roscopeco/atfprog-hardware/README.md

## ATF150x programmer (commercial)

Made non-proprietary and released to open-source with the
licenses outlined in LICENSE.md and LICENSE.hardware, 
under my authority on April 23rd 2025.

_Ross Bamford_

_Managing Director_

_The Really Old-School Company Limited_
