roscopeco/atfprog-hardware/ATF15xxProgBoard/ATF15xxProgBoard.pdf

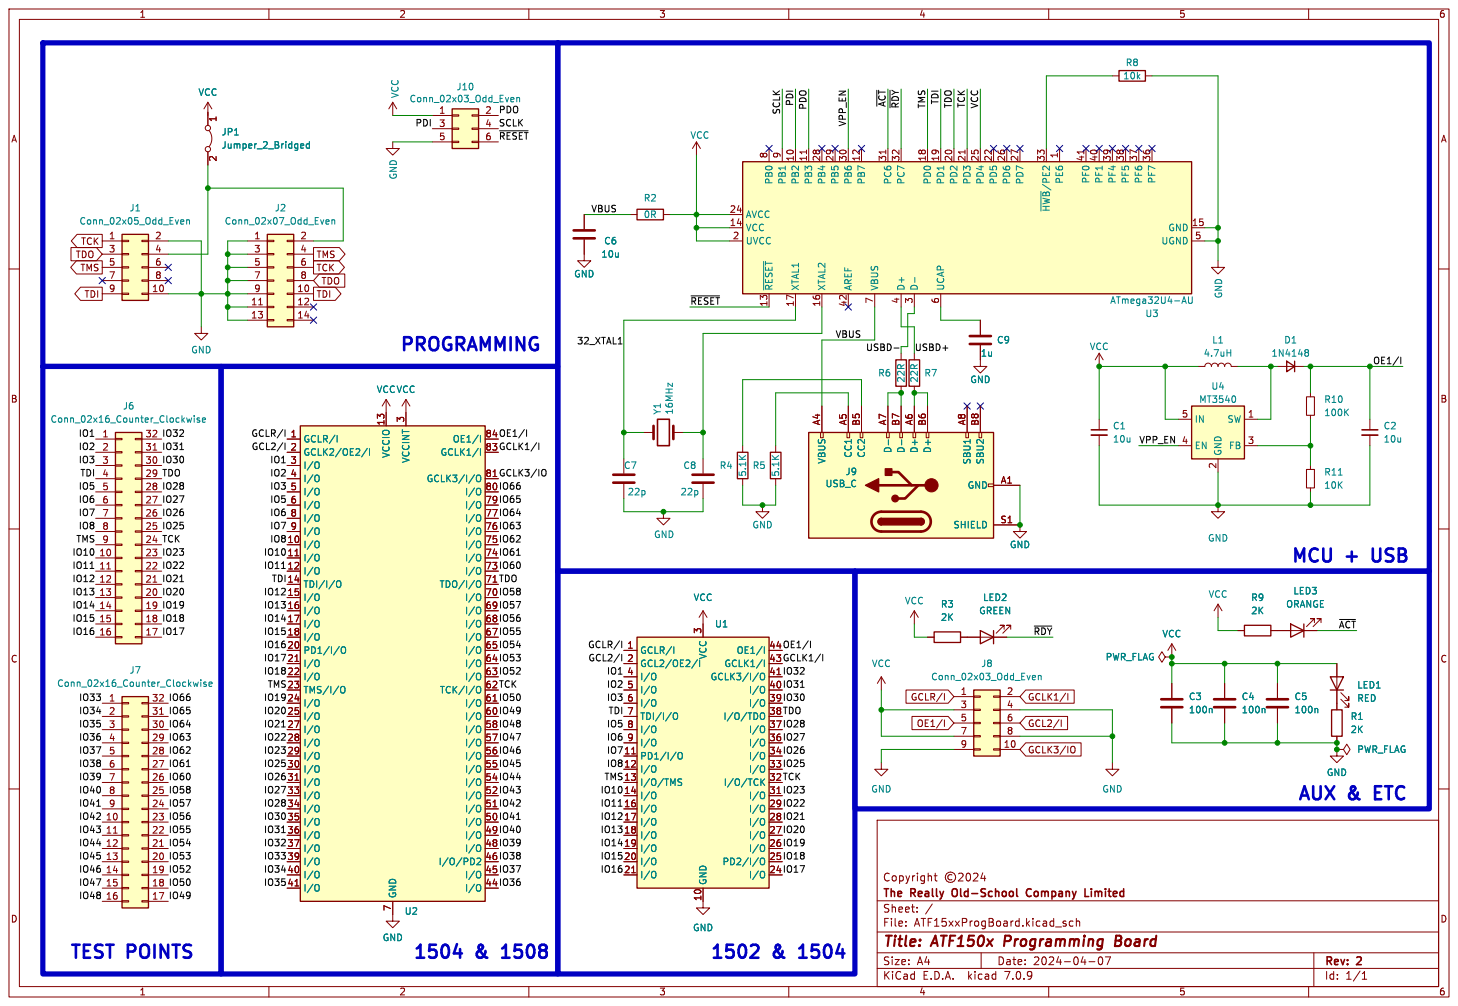
[picture p2: page 1]

1 PB2 10 PB3 11 PB7 12 ~{RESET} 13 VCC 14 GND 15 XTAL2 16 XTAL1 17 PD0 18 PD1 19 UVCC 2 PD2 20 PD3 21 PD5 22 AVCC 24 PD4 25 PD6 26 PD7 27 PB4 28 PB5 29 D- 3 PB6 30 PC6 31 PC7 32 ~{HWB}/PE233 PF7 36 PF6 37 PF5 38 PF4 39 D+

9 U3 ATmega32U4-AU GND A1 VBUS A4 CC1 A5 D+ A6 D- A7 SBU1 A8 CC2 B5 D+ B6 D- B7 SBU2 B8 SHIELD S1

Id: 1/1 Title: ATF150x Programming Board
