roscopeco/atfprog-hardware/ATF15xxProgBoard/ATF15xxProgBoard.kicad_pcb

## KiCad design ATF15xxProgBoard/ATF15xxProgBoard.kicad_pcb (2025-07-12)

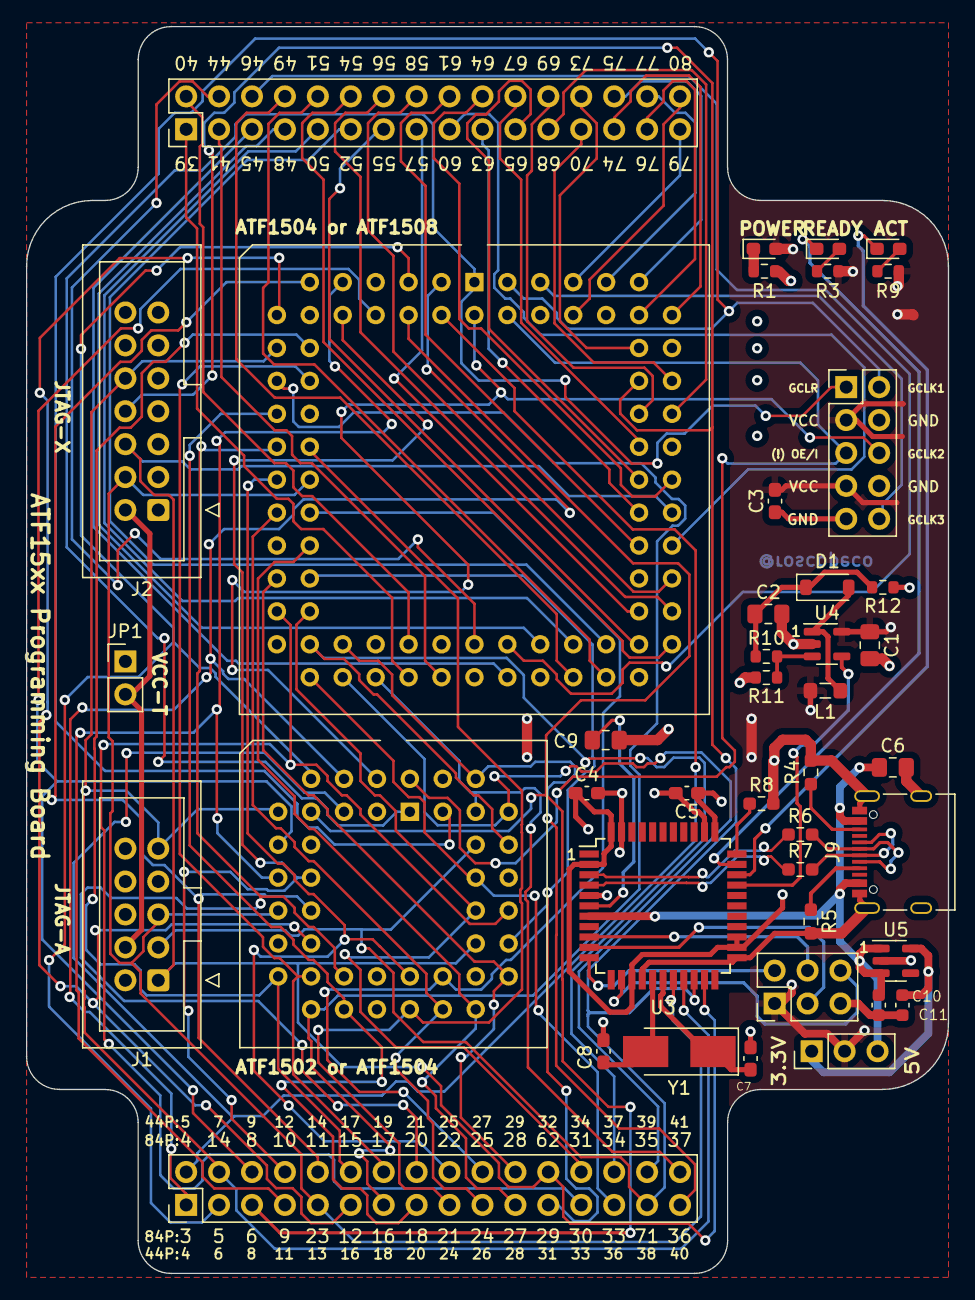
[picture p3: board ATF15xxProgBoard.kicad_pcb from above]

Board: 4 copper layers, 71.1 x 96.2 mm, 42 parts (0 on the bottom side), 97 nets.

Parts:
C1, C2, C6: 10u; C_0805_2012Metric_Pad1.18x1.45mm_HandSolder
C3, C4, C5: 100n; C_0603_1608Metric_Pad1.08x0.95mm_HandSolder
C7, C8: 22p; C_0603_1608Metric_Pad1.08x0.95mm_HandSolder
C9: 1u; C_0805_2012Metric_Pad1.18x1.45mm_HandSolder
C10, C11: 4.7u; C_0603_1608Metric
D1: 1N4148; D_SOD-123
J1: Conn_02x05_Odd_Even; IDC-Header_2x05_P2.54mm_Vertical
J2: Conn_02x07_Odd_Even; IDC-Header_2x07_P2.54mm_Vertical
J6, J7: Conn_02x16_Counter_Clockwise; PinHeader_2x16_P2.54mm_Vertical
J8: Conn_02x03_Odd_Even; PinHeader_2x05_P2.54mm_Vertical
J9: USB_C; USB_C_Receptacle_Palconn_UTC16-G
J10: Conn_02x03_Odd_Even; PinHeader_2x03_P2.54mm_Vertical
JP1: Jumper_2_Bridged; PinHeader_1x02_P2.54mm_Vertical
JP2: Voltage; PinHeader_1x03_P2.54mm_Vertical
L1: 4.7uH; L_0805_2012Metric_Pad1.05x1.20mm_HandSolder
LED1: RED; LED_0603_1608Metric_Pad1.05x0.95mm_HandSolder
LED2: GREEN; LED_0603_1608Metric_Pad1.05x0.95mm_HandSolder
LED3: ORANGE; LED_0603_1608Metric_Pad1.05x0.95mm_HandSolder
R1, R3, R9: 2K; R_0603_1608Metric
R4, R5: 5.1K; R_0603_1608Metric_Pad0.98x0.95mm_HandSolder
R6, R7: 22R; R_0603_1608Metric_Pad0.98x0.95mm_HandSolder
R8: 10k; R_0603_1608Metric_Pad0.98x0.95mm_HandSolder
R10: 100K; R_0603_1608Metric
R11: 10K; R_0603_1608Metric
R12: 2.2K; R_0603_1608Metric
U1: PLCC-44_THT-Socket
U2: PLCC-84_THT-Socket
U3: ATmega32U4-AU; TQFP-44_10x10mm_P0.8mm
U4: MT3540; SOT-23-5
U5: AP2127K-3.3; SOT-23-5
Y1: 8MHz; Crystal_SMD_5032-2Pin_5.0x3.2mm_HandSoldering

Connections:
+3V3: C11.1, JP2.1 (A), U5.5 (VOUT)
/32_XTAL1: C7.1, U3.17 (XTAL1), Y1.1
/IO1: J6.1, U1.4 (I/O), U2.3 (I/O)
/IO2: J6.2, U1.5 (I/O), U2.4 (I/O)
/IO3: J6.3, U1.6 (I/O), U2.5 (I/O)
/IO5: J6.5, U1.8 (I/O), U2.6 (I/O)
/IO6: J6.6, U1.9 (I/O), U2.8 (I/O)
/IO7: J6.7, U1.11 (PD1/I/O), U2.9 (I/O)
/IO8: J6.8, U1.12 (I/O), U2.10 (I/O)
/IO10: J6.10, U1.14 (I/O), U2.11 (I/O)
/IO11: J6.11, U1.16 (I/O), U2.12 (I/O)
/IO12: J6.12, U1.17 (I/O), U2.15 (I/O)
/IO13: J6.13, U1.18 (I/O), U2.16 (I/O)
/IO14: J6.14, U1.19 (I/O), U2.17 (I/O)
/IO15: J6.15, U1.20 (I/O), U2.18 (I/O)
/IO16: J6.16, U1.21 (I/O), U2.20 (PD1/I/O)
/IO17: J6.17, U1.24 (I/O), U2.21 (I/O)
/IO18: J6.18, U1.25 (PD2/I/O), U2.22 (I/O)
/IO19: J6.19, U1.26 (I/O), U2.24 (I/O)
/IO20: J6.20, U1.27 (I/O), U2.25 (I/O)
/IO21: J6.21, U1.28 (I/O), U2.27 (I/O)
/IO22: J6.22, U1.29 (I/O), U2.28 (I/O)
/IO23: J6.23, U1.31 (I/O), U2.29 (I/O)
/IO25: J6.25, U1.33 (I/O), U2.30 (I/O)
/IO26: J6.26, U1.34 (I/O), U2.31 (I/O)
/IO27: J6.27, U1.36 (I/O), U2.33 (I/O)
/IO28: J6.28, U1.37 (I/O), U2.34 (I/O)
/IO30: J6.30, U1.39 (I/O), U2.35 (I/O)
/IO31: J6.31, U1.40 (I/O), U2.36 (I/O)
/IO32: J6.32, U1.41 (GCLK3/I/O), U2.37 (I/O)
/IO33: J7.1, U2.39 (I/O)
/IO34: J7.2, U2.40 (I/O)
/IO35: J7.3, U2.41 (I/O)
/IO36: J7.4, U2.44 (I/O)
/IO37: J7.5, U2.45 (I/O)
/IO38: J7.6, U2.46 (I/O/PD2)
/IO39: J7.7, U2.48 (I/O)
/IO40: J7.8, U2.49 (I/O)
/IO41: J7.9, U2.50 (I/O)
/IO42: J7.10, U2.51 (I/O)
/IO43: J7.11, U2.52 (I/O)
/IO44: J7.12, U2.54 (I/O)
/IO45: J7.13, U2.55 (I/O)
/IO46: J7.14, U2.56 (I/O)
/IO47: J7.15, U2.57 (I/O)
/IO48: J7.16, U2.58 (I/O)
/IO49: J7.17, U2.60 (I/O)
/IO50: J7.18, U2.61 (I/O)
/IO52: J7.19, U2.63 (I/O)
/IO53: J7.20, U2.64 (I/O)
/IO54: J7.21, U2.65 (I/O)
/IO55: J7.22, U2.67 (I/O)
/IO56: J7.23, U2.68 (I/O)
/IO57: J7.24, U2.69 (I/O)
/IO58: J7.25, U2.70 (I/O)
/IO60: J7.26, U2.73 (I/O)
/IO61: J7.27, U2.74 (I/O)
/IO62: J7.28, U2.75 (I/O)
/IO63: J7.29, U2.76 (I/O)
/IO64: J7.30, U2.77 (I/O)
/IO65: J7.31, U2.79 (I/O)
/IO66: J7.32, U2.80 (I/O)
/PDI: J10.3, U3.10 (PB2)
/PDO: J10.2, U3.11 (PB3)
/SCLK: J10.4, U3.9 (PB1)
/USBD+: R7.1, U3.4 (D+)
/USBD-: R6.1, U3.3 (D-)
/VPP_EN: U3.30 (PB6), U4.4 (EN)
/~ACT: LED3.1 (K), U3.31 (PC6)
/~RDY: LED2.1 (K), U3.32 (PC7)
/~RESET: J10.6, U3.13 (~RESET)
GCL2/I: J8.6, U1.2 (GCL2/OE2/I), U2.2 (GCLK2/OE2/I)
GCLK1/I: J8.2, U1.43 (GCLK1/I), U2.83 (GCLK1/I)
GCLK3/IO: J8.10, U2.81 (GCLK3/I/O)
GCLR/I: J8.1, U1.1 (GCLR/I), U2.1 (GCLR/I)
GND: C1.2, C2.2, C3.1, C4.2, C5.2, C6.2, C7.2, C8.2, C9.2, C10.2, C11.2, J1.2, J1.10, J2.1, J2.3, J2.5, J2.7, J2.9, J2.11, J2.13, J8.4, J8.8, J8.9, J9.A1 (GND), J9.A12 (GND), J9.B1 (GND), J9.B12 (GND), J9.S1 (SHIELD), J10.5, R1.2, R4.2, R5.2, R8.1, R11.2, U1.10 (GND), U1.22 (GND), U1.30 (GND), U1.42 (GND), U2.7 (GND), U2.19 (GND), U2.32 (GND), U2.42 (GND), U2.47 (GND), U2.59 (GND), U2.72 (GND), U2.82 (GND), U3.5 (UGND), U3.15 (GND), U3.23 (GND), U3.35 (GND), U3.43 (GND), U4.2 (GND), U5.2 (GND)
unnamed: D1.2 (A), L1.2, U4.1 (SW)
unnamed: C2.1, D1.1 (K), R10.1, R12.2
unnamed: J1.4, J2.2, JP1.2 (B)
unnamed: J9.A5 (CC1), R5.1
unnamed: J9.B5 (CC2), R4.1
unnamed: J9.A6 (D+), J9.B6 (D+), R7.2
unnamed: J9.A7 (D-), J9.B7 (D-), R6.2
unnamed: LED1.1 (K), R1.1
unnamed: LED2.2 (A), R3.2
unnamed: LED3.2 (A), R9.2
unnamed: C9.1, U3.6 (UCAP)
unnamed: C8.1, U3.16 (XTAL2), Y1.2
unnamed: R8.2, U3.33 (~HWB/PE2)
unnamed: R10.2, R11.1, U4.3 (FB)
OE1/I: J8.5, R12.1, U1.44 (OE1/I), U2.84 (OE1/I)
TCK: J1.1, J2.6, J6.24, U1.32 (I/O/TCK), U2.62 (TCK/I/O), U3.21 (PD3)
TDI: J1.9, J2.10, J6.4, U1.7 (TDI/I/O), U2.14 (TDI/I/O), U3.19 (PD1)
TDO: J1.3, J2.8, J6.29, U1.38 (I/O/TDO), U2.71 (TDO/I/O), U3.20 (PD2)
TMS: J1.5, J2.4, J6.9, U1.13 (I/O/TMS), U2.23 (TMS/I/O), U3.18 (PD0)
VBUS: C6.1, C10.1, J9.A4 (VBUS), J9.A9 (VBUS), J9.B4 (VBUS), J9.B9 (VBUS), JP2.3 (B), U3.7 (VBUS), U5.1 (VIN), U5.3 (EN)
VCC: C1.1, C3.2, C4.1, C5.1, J8.3, J8.7, J10.1, JP1.1 (A), JP2.2 (C), L1.1, LED1.2 (A), R3.1, R9.1, U1.3 (VCC), U1.15 (VCC), U1.23 (VCC), U1.35 (VCC), U2.13 (VCCIO), U2.26 (VCCIO), U2.38 (VCCIO), U2.43 (VCCINT), U2.53 (VCCIO), U2.66 (VCCIO), U2.78 (VCCIO), U3.2 (UVCC), U3.14 (VCC), U3.24 (AVCC), U3.25 (PD4), U3.34 (VCC), U3.44 (AVCC), U4.5 (IN)
