roscopeco/atfprog-hardware/(commit log)

2024-04-12 COMMERCIAL: Full redesign as programmer
    [ATF15xxProgBoard-B_Cu.gbr, ATF15xxProgBoard-B_Mask.gbr, ATF15xxProgBoard-B_Paste.gbr, ATF15xxProgBoard-B_Silkscreen.gbr, ATF15xxProgBoard-CuBottom.gbr, ATF15xxProgBoard-CuIn1.gbr, ATF15xxProgBoard-CuIn2.gbr, ATF15xxProgBoard-CuTop.gbr]
2024-04-25 Minor tidy up
    [ATF15xxProgBoard-CuBottom.gbr, ATF15xxProgBoard-CuIn1.gbr, ATF15xxProgBoard-CuIn2.gbr, ATF15xxProgBoard-CuTop.gbr, ATF15xxProgBoard-EdgeCuts.gbr, ATF15xxProgBoard-MaskBottom.gbr, ATF15xxProgBoard-MaskTop.gbr, ATF15xxProgBoard-NPTH.drl]
2024-04-25 Functionality for programmer board
2025-07-12 Open sourcing
    [ATF15xxProgBoard.kicad_pcb, ATF15xxProgBoard.kicad_sch]
