roscopeco/atfprog-hardware/(notices)

Notices in the files:
ATF15xxProgBoard/ATF15xxProgBoard.kicad_pcb:
Copyright ©2024
